eastpeak001/STM32-Desktop-Console-V1.5/hardware/bom/lcsc_parts.md

# LCSC Parts List

| 功能 | 立创编号 | 品牌 | 封装/规格 | 说明 |
|---|---|---|---|---|
| STM32 核心板插座 | C297789 | ZHOURI / 洲日 | 2.54mm 2×20P 双排母 | 插 STM32F103C8T6 最小系统板 |
| 通用模块排母 | C9811 | BOOMELE / 博穆精密 | 2.54mm 1×40P 圆母，可裁剪 | 用于 OLED、AHT20、MPU6050、BT24、MAX7219、W25Q64 等接口 |
| UART 调试排针 | C2337 | BOOMELE / 博穆精密 | 2.54mm 1×40P 直针，可裁剪 | UART 调试口 |
| KF301-5.0-2P | C474881 | 以立创商城页面为准 | 插件，5.0mm，2P | 5V 输入端子 |
| 自恢复保险丝 | C70113 | 以立创商城页面为准 | 1812，500mA | 输入保护 |
| AMS1117-3.3 | C347222 | 以立创商城页面为准 | SOT-223 | 5V 转 3.3V |
| 10uF 电容 | C15850 | Samsung Electro-Mechanics | 0805 | 电源滤波 |
| 100nF 电容 | C49678 | YAGEO / 国巨 | 0805 | 去耦 |
| 4.7k 电阻 | C17673 | UNI-ROYAL / 厚声 | 0805 | I2C 上拉，默认可不焊 |
| 1k 电阻 | C2991619 | 以立创商城页面为准 | 0805 | LED 限流 |
| EC11 编码器 | C2991196 | ALPSALPINE | 插件 EC11 | 菜单控制 |
| 6×6 按键 | C39338 | SHOU HAN / 首韩 | 插件 6×6mm | OK / RESET |
| 3mm 红色 LED | C568936 | HL / 皓亮 | 插件 3mm | 电源/状态指示 |
| 电源拨动开关 | C5274456 | 以立创商城页面为准 | 插件拨动开关 | 总电源开关 |

## 外部模块

以下模块为成品模块，需单独购买：

| 模块 | 说明 |
|---|---|
| STM32F103C8T6 最小系统板 | 主控核心板 |
| 0.96 寸 I2C OLED | 显示模块 |
| AHT20 模块 | 温湿度传感器 |
| MPU6050 模块 | 姿态传感器 |
| MAX7219 8×8 点阵模块 | 点阵显示 |
| W25Q64 模块 | SPI Flash 存储 |
| BT24 蓝牙模块 | 蓝牙串口通信 |
| 光敏模块 | 环境光检测 |
| 低电平触发蜂鸣器模块 | 声音提示 |

## 说明

- 多个接口使用 C9811 1×40P 排母裁剪。
- I2C 上拉电阻默认可不焊。
- 下单前请再次确认立创商城库存、封装和价格。
