eastpeak001/STM32-Desktop-Console-V1.5/(commit log)

2026-05-01 Initial open source release of STM32 Desktop Console V1.5
2026-05-02 Add hardware documents and PCB layout image
2026-05-02 Add PCB and schematic preview images
2026-05-02 Add Gerber files for hardware V1.5
